IC3DPrinters/filament-extrusion/Open Source Filament/CAD/Breaker Plate/Breaker Plate Outlet.JPG

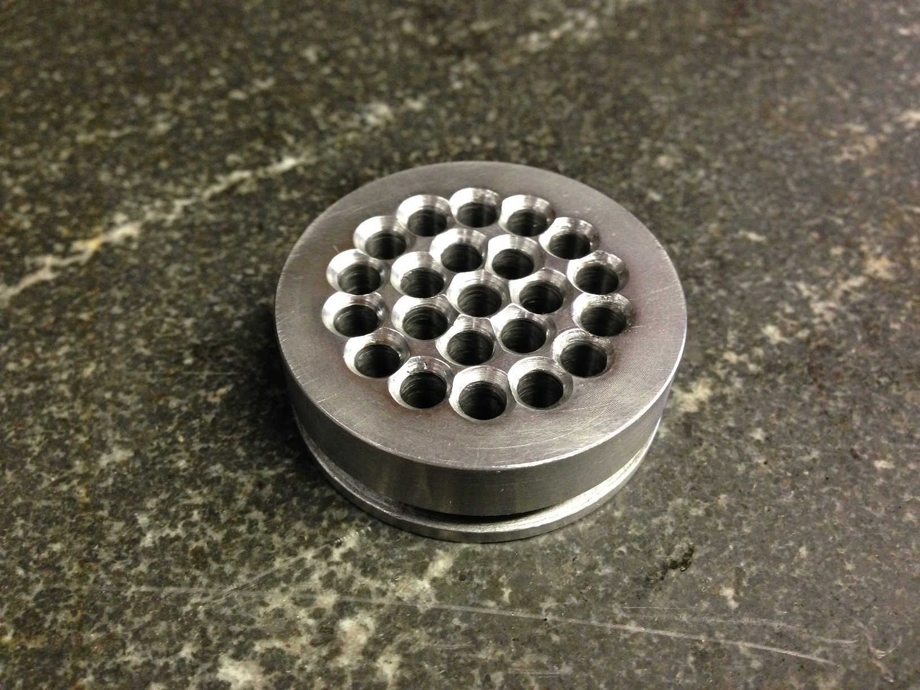
Open Source Filament/CAD/Breaker Plate/Breaker Plate Outlet.JPG
