IC3DPrinters/filament-extrusion/Open Source Filament/Resin Info/ABS Resin/Chimei General PA-747_ISO.pdf

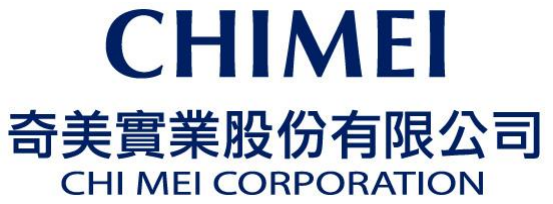
[picture p3: figure]

### No. 59-1, SAN CHIA, JEN TE DISTRICT, TAINAN CITY, TAIWAN TEL: +886-6-266-5000 FAX:+886-6-266-5555~7

The above statement is based on our current level of knowledge and covers the above products directly manufactured and supplied by CHI MEI CORPORATION at the date of issue. CHI MEI CORPORATION makes no warranties, whether express or implied, and assumes no liability in connection with any use of above information. Notwithstanding the foregoing, CHI MEI CORPORATION shall in no event be held obligated or liable for any claims due to or arising from (i) any customer provided, consigned, materials and/or parts, which are incorporated or adopted in the products; (ii) any combination of the products with material not provided or authorized by our company; (iii) any modifications to the products which are made or directed by customer; (iv) our compliance with the specifications, instructions, and/or designs provided by customer; (v) any anti-trust, unfair competition and/or other unlawful actions effected by customer; or (vi) any defects, infringement, breach and/or violation which are arising out of customer’s faults or otherwise not solely and directly attributable to CHI MEI CORPORATION. In no event will CHI MEI CORPORATION be liable for any indirect, special, exemplary, punitive, or consequential damages (including lost profits) of any nature whatsoever whether arising out of the purchase, shipment, unloading, handling, or use of any product or otherwise.

# General ABS POLYLAC® Characteristics PA⁻747

特性

### PROPERTIES

## 測試方法

### ISO TEST METHOD

## 測試條件

### TEST CONDITION

單位

### UNIT

### 通用級 GENERAL

PA-747

熔融指數 Melt Flow Index | 1133 | 220 ℃, 10 Kg | ml/10 min | 13
比重 Mass Density | 1183 | 23 ℃ | g/cm³ | 1.03
硬度 Ball Indentation Hardness | 2039-1 | H358/30 | N/mm² | 88
拉伸強度 Tensile Strength | 527 | 50 mm/min,yield | MPa | 39
| | 50 mm/min,break | MPa | 31
延伸率 Tensile Elongation | 527 | 50 mm/min | % | 45
彎曲強度 Flexural Strength | 178 | 2 mm/min | MPa | 58
彎曲彈性模數 Flexural Modulus | 178 | 2 mm/min | GPa | 1.8
IZOD 衝擊強度 Izod Impact Strength | 180/1A | Notched | Kj/m² | 34
| 180/1C | Unnotched | | -
Charpy 衝擊強度 Charpy Impact Strength | 179 | Notched | Kj/m² | 37
撓衝試驗 Impact Flexural Test | 179/2C | Notched | Kj/m² | 21
| 179/2D | Unnotched | | -
維氏軟化溫度 Vicat Softening Temp. | 306 | 1 Kg,50 ℃/hr | ℃ | 101
| | 5 Kg,50 ℃/hr | | 92
| | 1 Kg,120 ℃/hr | | 103
| | 5 Kg,120 ℃/hr | | 94
熱變形溫度 Heat Distortion Temp. / A | 75 | 1.8 MPa Unannealed | ℃ | 86
| | 1.8 MPa Annealed | ℃ | 96
UL 燃燒等級 UL Flammability | - | UL-94 | - | 1.5 mm HB

April 8, 2013

Notes：These are typical properties only and are not to be construed as specifications. Users should confirm

results by their own tests.
