IC3DPrinters/filament-extrusion/Open Source Filament/CAD/Breaker Plate/Breaker Plate Inlet.JPG

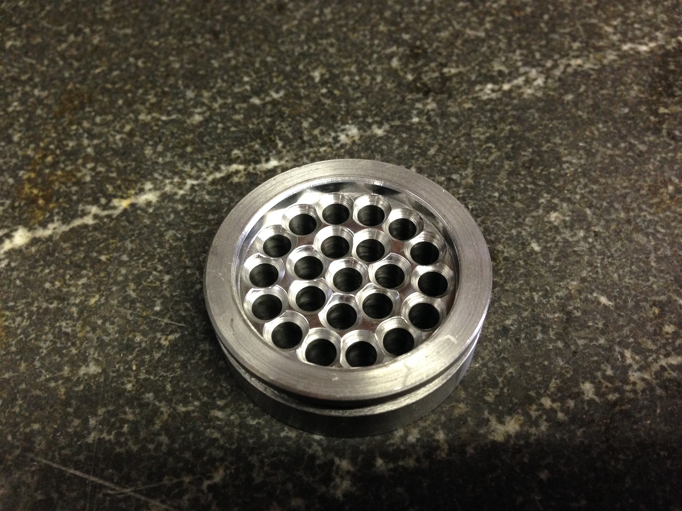
Open Source Filament/CAD/Breaker Plate/Breaker Plate Inlet.JPG
