IC3DPrinters/filament-extrusion/Open Source Filament/CAD/Extrusion Dies/Extrusion Die 3mm b.jpeg

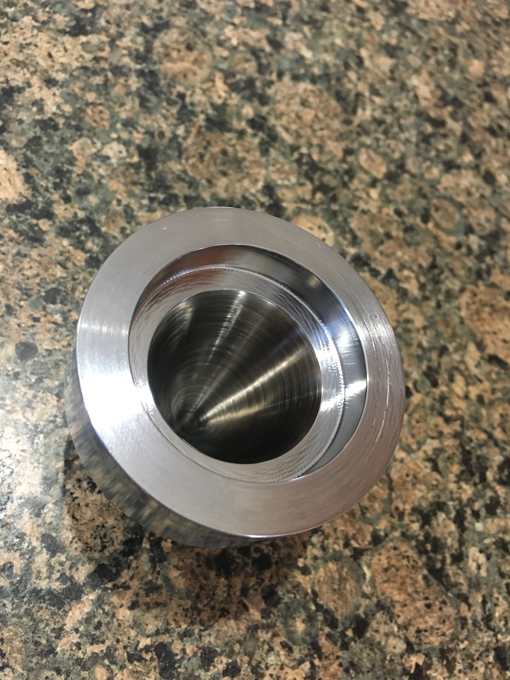
Open Source Filament/CAD/Extrusion Dies/Extrusion Die 3mm b.jpeg
