IC3DPrinters/filament-extrusion/Open Source Filament/CAD/Extrusion Dies/Extrusion Die 3mm c.jpeg

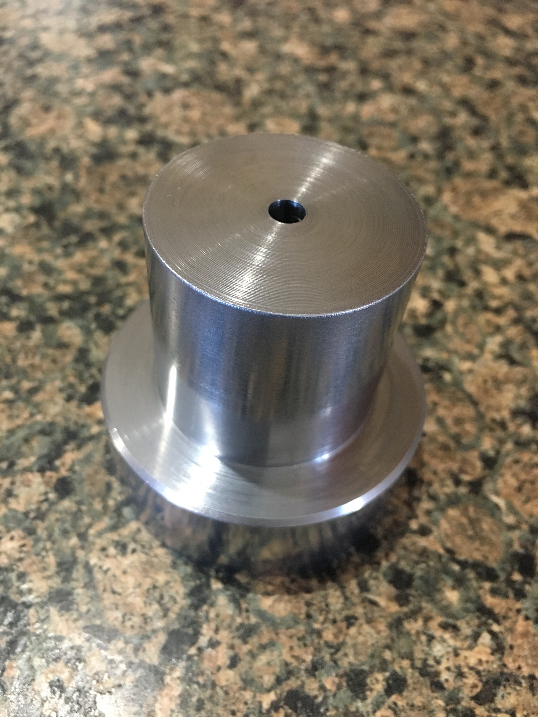
Open Source Filament/CAD/Extrusion Dies/Extrusion Die 3mm c.jpeg
