IC3DPrinters/filament-extrusion/Open Source Filament/CAD/Filament Stabilizers/Filament Vertical CrossSection.jpg

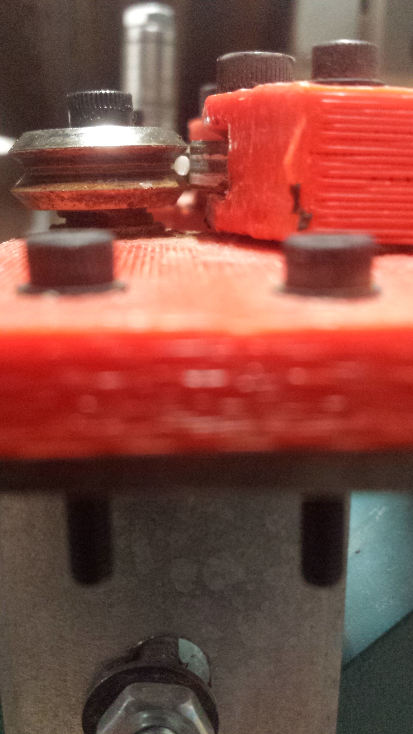
Open Source Filament/CAD/Filament Stabilizers/Filament Vertical CrossSection.jpg
