IC3DPrinters/filament-extrusion/Open Source Filament/Media/ABSNatural.png

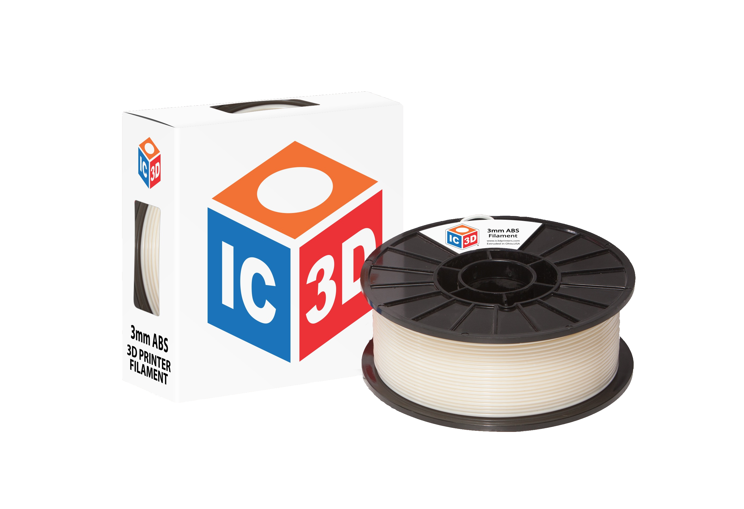
Open Source Filament/Media/ABSNatural.png
