IC3DPrinters/filament-extrusion/Open Source Filament/CAD/Respooler/HBLFSN6.sldasm

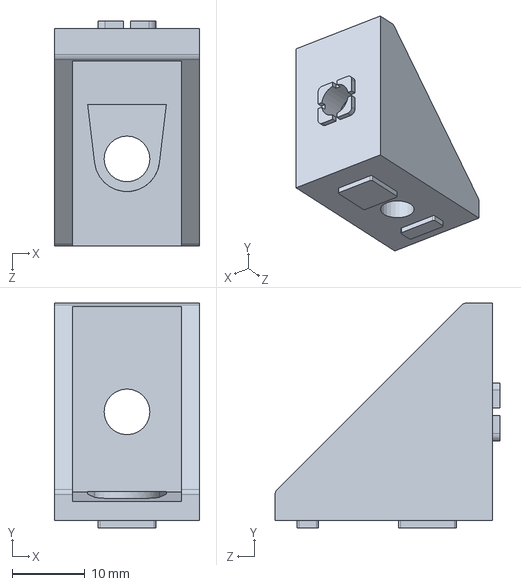
[picture p9: CAD file, 2017-04-15]
Open Source Filament/CAD/Respooler/HBLFSN6.sldasm
20.0 x 31.0 x 31.0 mm
