IC3DPrinters/filament-extrusion/Open Source Filament/CAD/Respooler/Pulley Assy Traverse.SLDASM

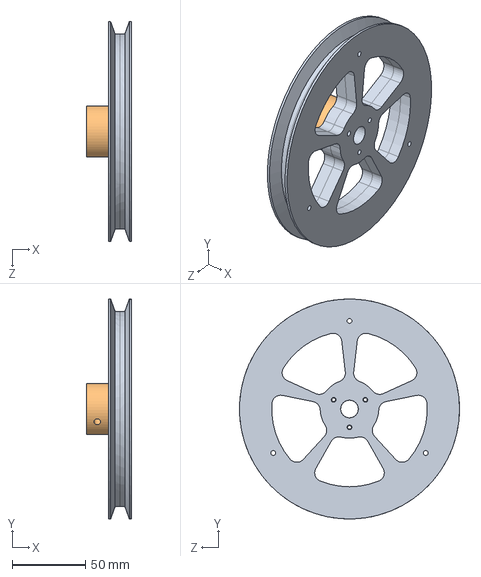
[picture p10: CAD file, 2017-04-15]
Open Source Filament/CAD/Respooler/Pulley Assy Traverse.SLDASM
31.0 x 149.9 x 150.0 mm
Pulley Outer Traverse x 2
Adapter Traverse Pulley
