IC3DPrinters/filament-extrusion/Open Source Filament/CAD/Filament Stabilizers/Filament Holder Subassy.SLDASM

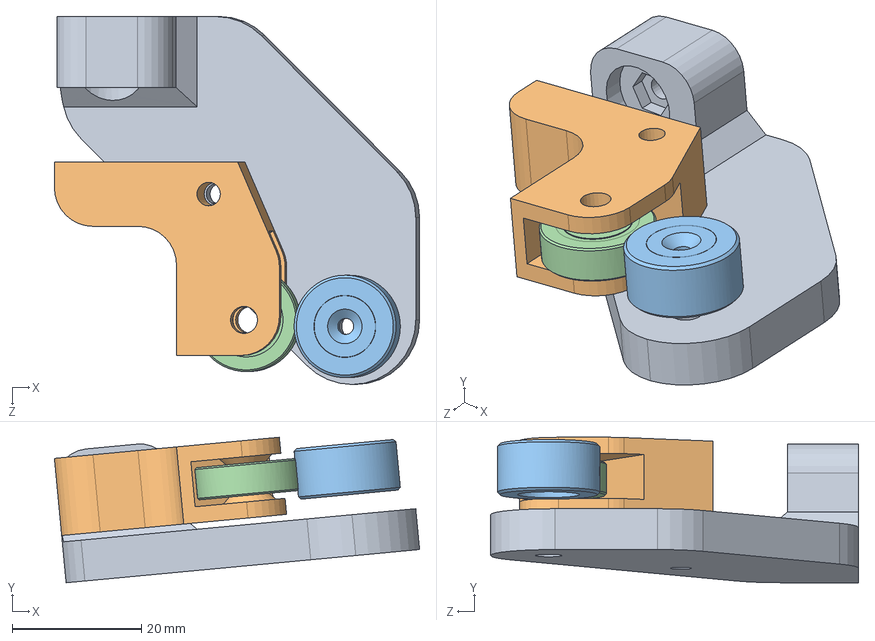
[picture p11: CAD file, 2017-04-15]
Open Source Filament/CAD/Filament Stabilizers/Filament Holder Subassy.SLDASM
56.6 x 22.5 x 57.0 mm
Bearing Plate
Bearing spring loaded holder
3_16 Groove Bearing
6153K150
