IC3DPrinters/filament-extrusion/Open Source Filament/CAD/Filament Stabilizers/Laser Filament Holder.SLDASM

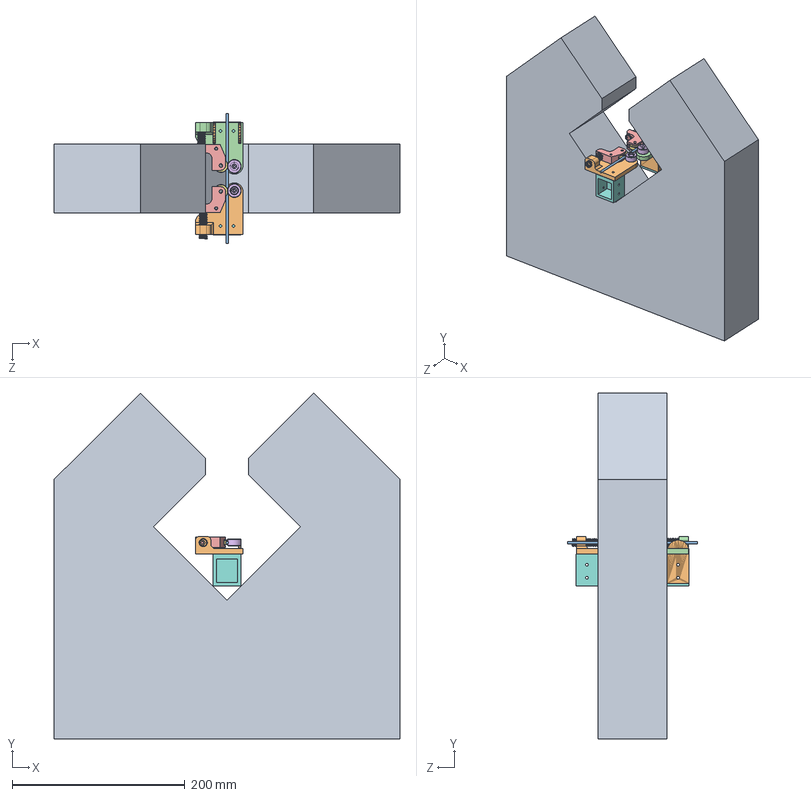
[picture p12: CAD file, 2017-04-15]
Open Source Filament/CAD/Filament Stabilizers/Laser Filament Holder.SLDASM
400.0 x 400.0 x 150.0 mm
Laser Gauge
3mm Filament
Bearing Plate
Bearing spring loaded holder x 2
3_16 Groove Bearing x 2
6153K150 x 2
Mount Block x 2
Spring 0.375 9657K135 x 2
Bearing Plate Sym
