IC3DPrinters/filament-extrusion/Open Source Filament/CAD/Respooler/Large Spool Payoff.sldasm

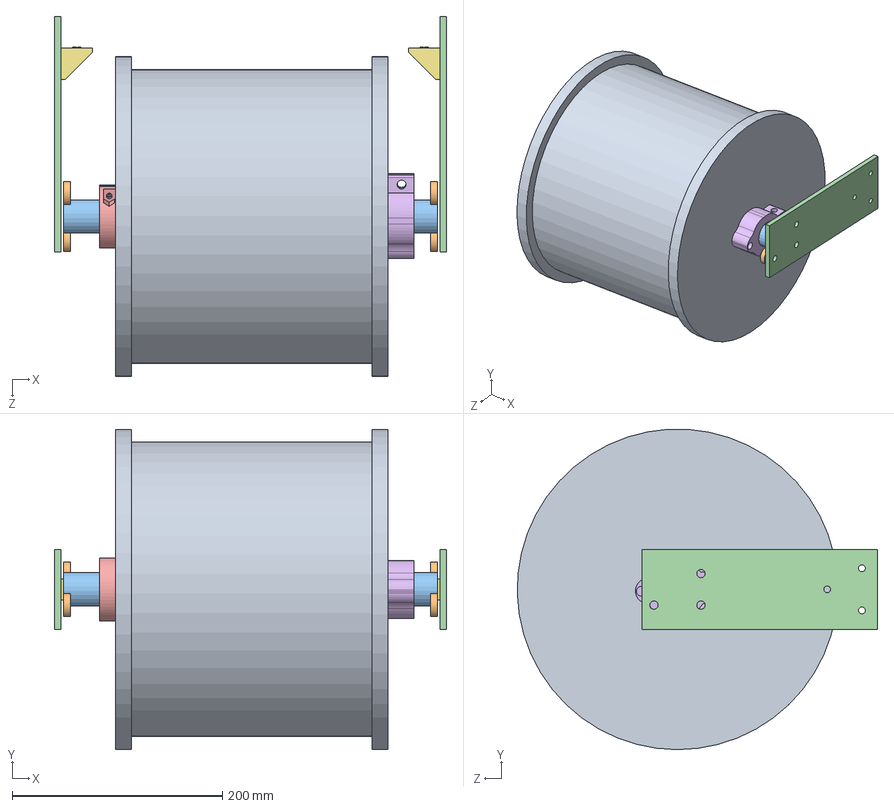
[picture p13: CAD file, 2017-04-15]
Open Source Filament/CAD/Respooler/Large Spool Payoff.sldasm
372.7 x 304.5 x 342.6 mm
Spool 12in
C608ZZ x 6
Rod Spool Big
Side Plate Big Spool x 2
Spooler Stopper Fixed
Spooler Stopper Quick
HBLFSN6_ x 2
