IC3DPrinters/filament-extrusion/Open Source Filament/CAD/Filament Stabilizers/Filament Holder Subassy Sym.SLDASM

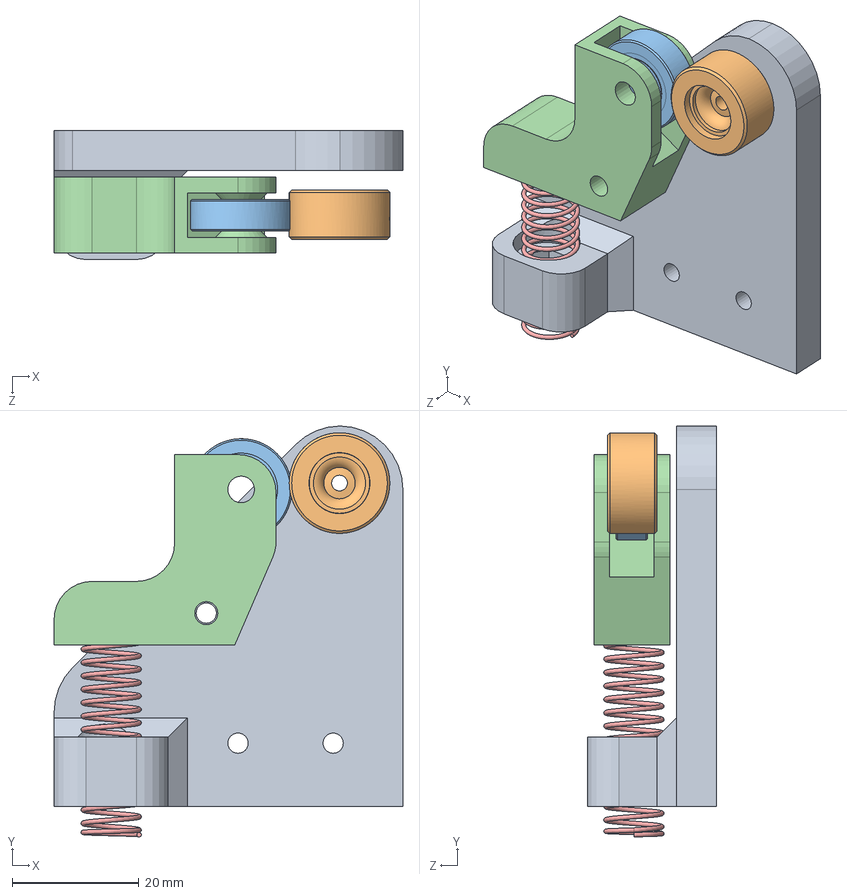
[picture p14: CAD file, 2017-04-15]
Open Source Filament/CAD/Filament Stabilizers/Filament Holder Subassy Sym.SLDASM
55.0 x 64.8 x 20.3 mm
Bearing Plate Sym
3_16 Groove Bearing
6153K150
Bearing spring loaded holder
Spring 0.375 9657K135
