IC3DPrinters/filament-extrusion/Open Source Filament/CAD/Respooler/Pulley Assy Motor.SLDASM

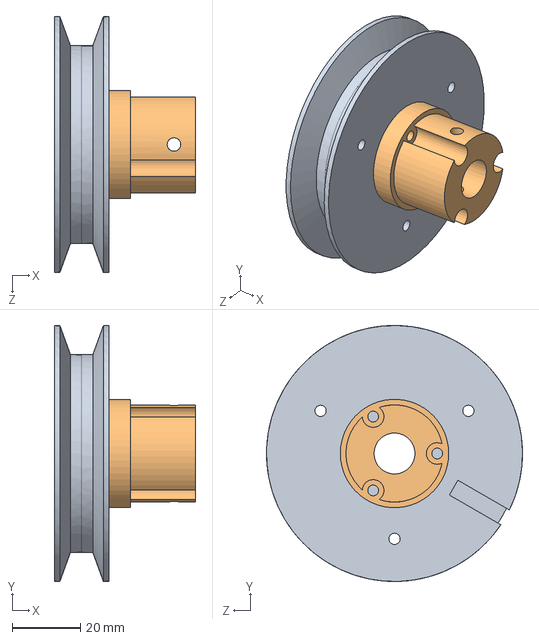
[picture p15: CAD file, 2017-04-15]
Open Source Filament/CAD/Respooler/Pulley Assy Motor.SLDASM
41.4 x 75.0 x 75.0 mm
Pulley Outer Motor x 2
Pulley Shaft Adapter (Motor)
