IC3DPrinters/filament-extrusion/Open Source Filament/CAD/Respooler/Respooler.SLDASM

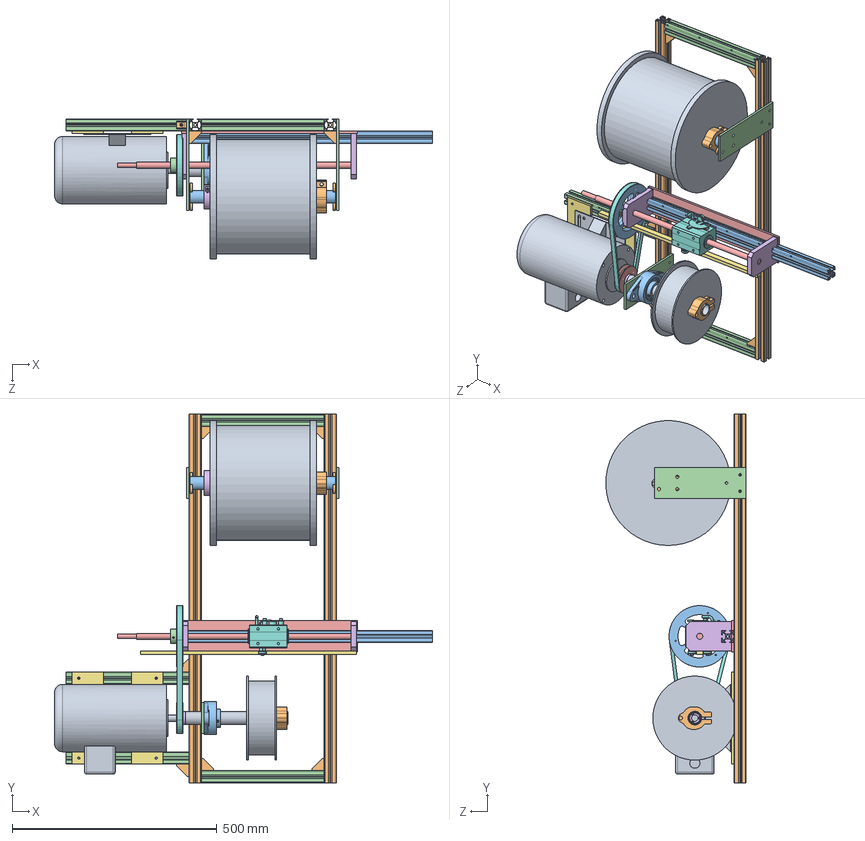
[picture p16: CAD file, 2017-04-15]
Open Source Filament/CAD/Respooler/Respooler.SLDASM
922.7 x 900.0 x 342.6 mm
Spool 8in
HFS6-3030-900 x 2
HFS6-3030-300 x 4
Traverse Spindle
Traverse Endplate x 2
Traverse Stabilizing Beam
Coilaide OKA15_3D
Electric Motor 1HP
HBLFSN6_ x 9
UCFL 206-20_UCFL 2-Bolt Flange Units_IPTCI Bearings__889BF_1CAF338
Mount Pillow Block
Traverse Mount Plate
Spooler Stopper Fixed x 2
M8x12 Flat Screw x 3
Belt
Rod Spool Small
Spooler Stopper Quick x 2
Pulley Outer Traverse x 2
Adapter Traverse Pulley
Pulley Outer Motor x 2
Pulley Shaft Adapter (Motor)
Motor Mount Plate x 2
5_16 Nut
C608ZZ x 6
Rod Spool Big
Side Plate Big Spool x 2
