IC3DPrinters/filament-extrusion/Open Source Filament/CAD/Respooler/Traverse Assy.SLDASM

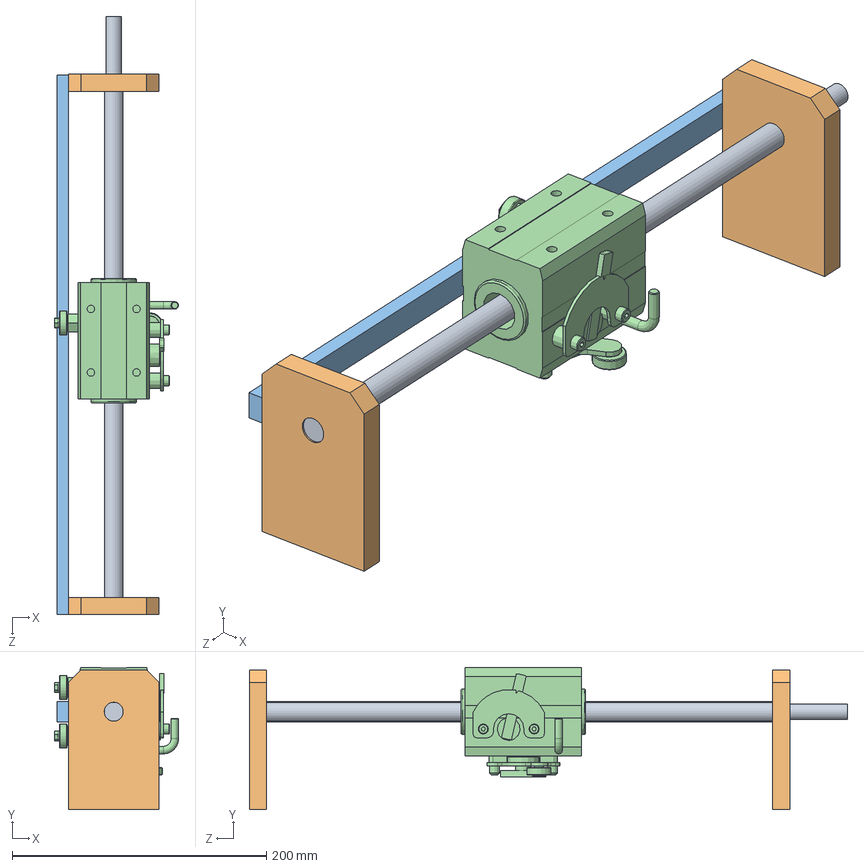
[picture p17: CAD file, 2017-04-15]
Open Source Filament/CAD/Respooler/Traverse Assy.SLDASM
97.8 x 111.8 x 471.0 mm
Traverse Spindle
Traverse Endplate x 2
Traverse Stabilizing Beam
Coilaide OKA15_3D
