IC3DPrinters/filament-extrusion/Open Source Filament/CAD/Breaker Plate/Breaker Plate 2014.01.12.STEP

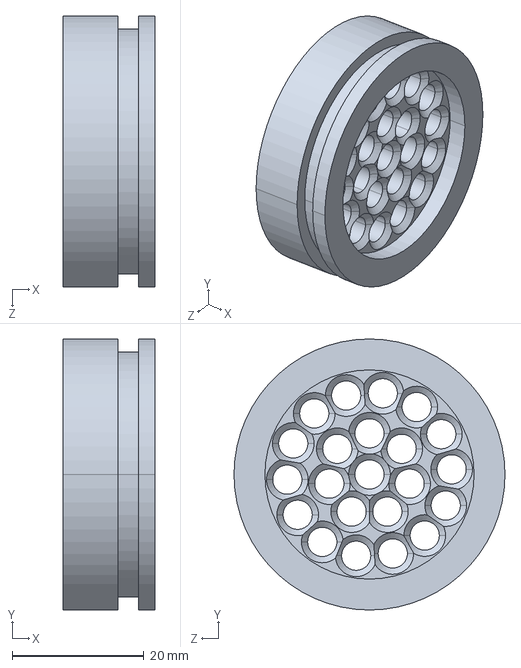
[picture p18: CAD file, 2017-04-15]
Open Source Filament/CAD/Breaker Plate/Breaker Plate 2014.01.12.STEP
14.0 x 41.1 x 41.1 mm
