IC3DPrinters/filament-extrusion/Open Source Filament/CAD/Extrusion Dies/Extrusion Die 1.75mm 2013.12.23.STEP

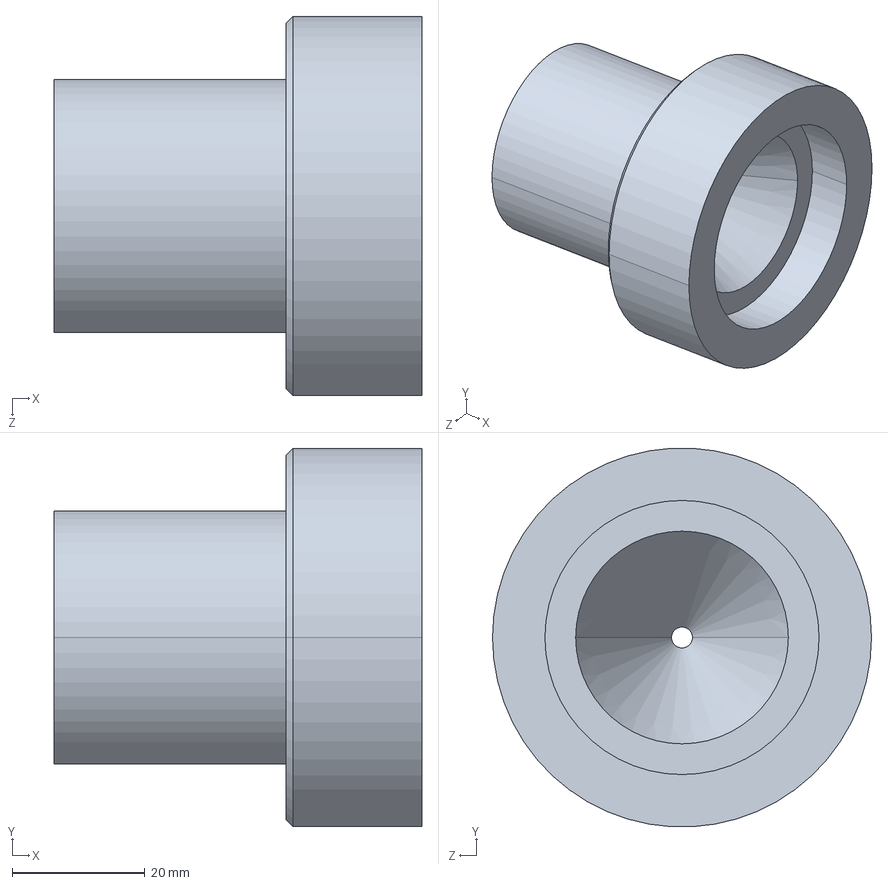
[picture p19: CAD file, 2017-04-15]
Open Source Filament/CAD/Extrusion Dies/Extrusion Die 1.75mm 2013.12.23.STEP
55.3 x 56.9 x 57.0 mm
