IC3DPrinters/filament-extrusion/Open Source Filament/CAD/Respooler/HFS6-3030-300.sldprt

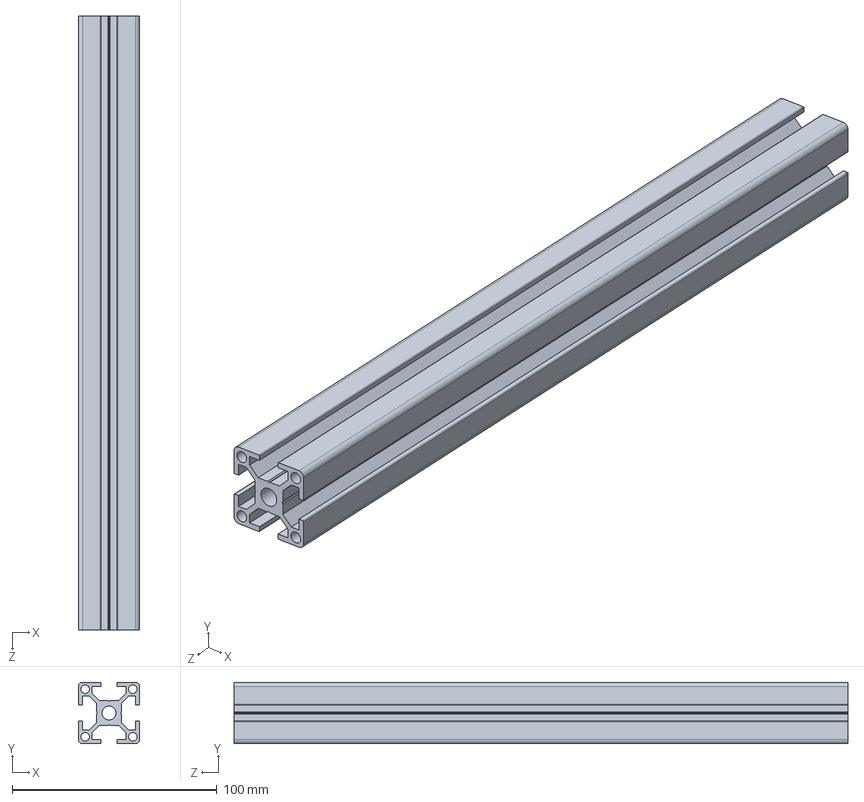
[picture p20: CAD file, 2017-04-15]
Open Source Filament/CAD/Respooler/HFS6-3030-300.sldprt
30.0 x 30.0 x 300.0 mm
