IC3DPrinters/filament-extrusion/Open Source Filament/CAD/Filament Stabilizers/Bearing Plate.sldprt

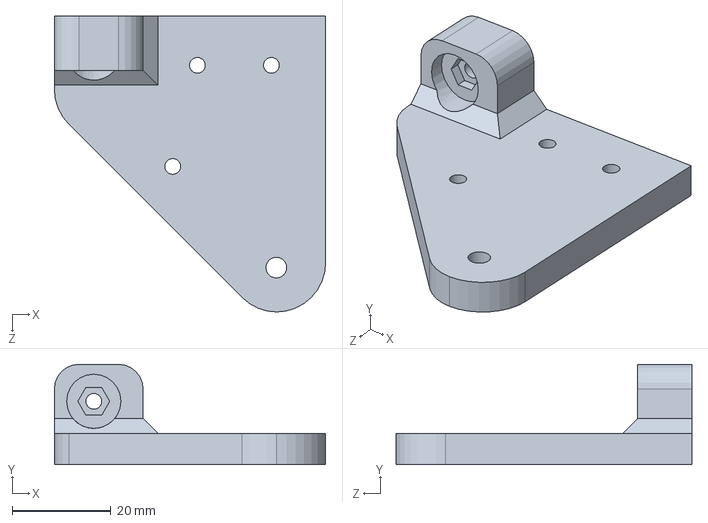
[picture p21: CAD file, 2017-04-15]
Open Source Filament/CAD/Filament Stabilizers/Bearing Plate.sldprt
55.0 x 20.3 x 60.0 mm
