IC3DPrinters/filament-extrusion/Open Source Filament/CAD/Respooler/Traverse Endplate.SLDPRT

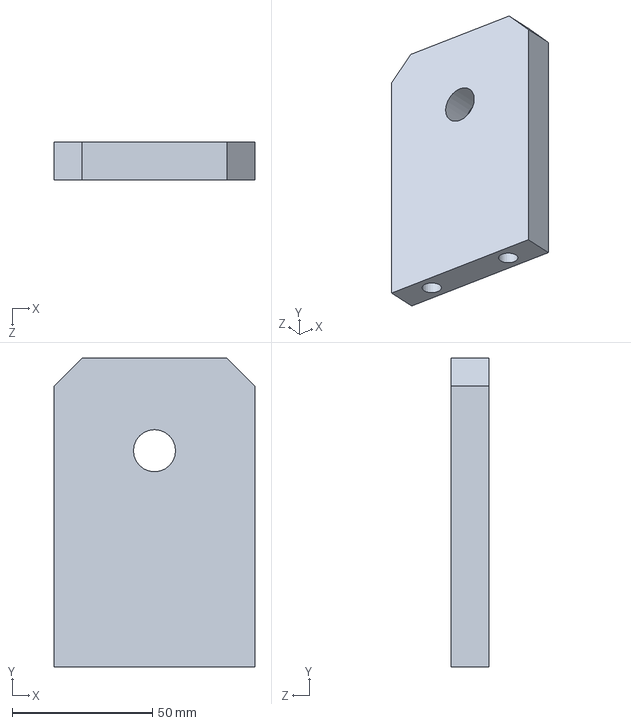
[picture p22: CAD file, 2017-04-15]
Open Source Filament/CAD/Respooler/Traverse Endplate.SLDPRT
71.5 x 110.0 x 13.5 mm
