IC3DPrinters/filament-extrusion/Open Source Filament/CAD/Respooler/Belt.SLDPRT

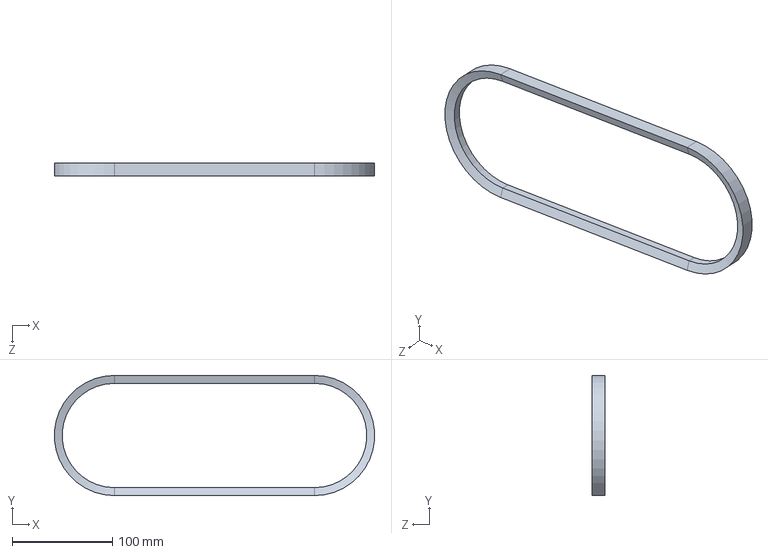
[picture p23: CAD file, 2017-04-15]
Open Source Filament/CAD/Respooler/Belt.SLDPRT
319.6 x 120.0 x 12.7 mm
