IC3DPrinters/filament-extrusion/Open Source Filament/CAD/Filament Stabilizers/Spring Conical 1692K260.SLDPRT

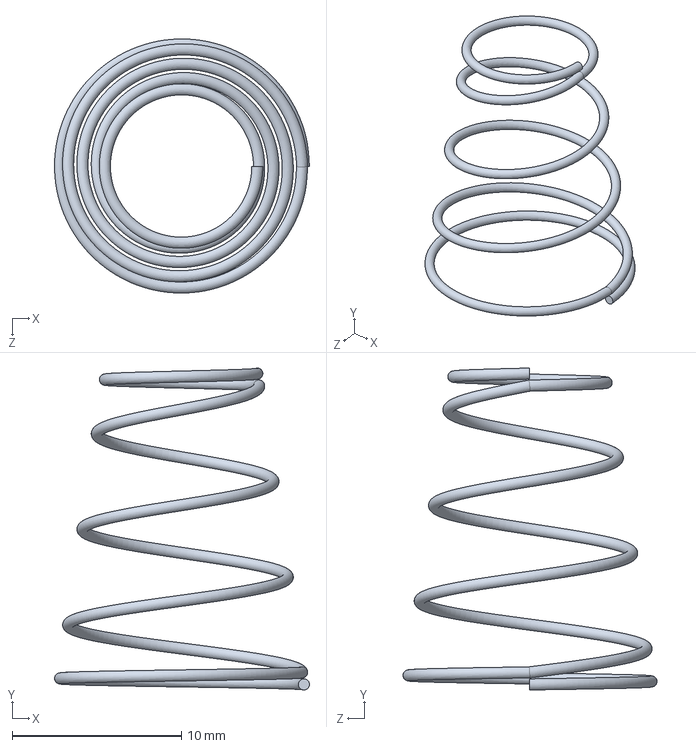
[picture p24: CAD file, 2017-04-15]
Open Source Filament/CAD/Filament Stabilizers/Spring Conical 1692K260.SLDPRT
15.1 x 19.1 x 15.0 mm
