IC3DPrinters/filament-extrusion/Open Source Filament/CAD/Filament Stabilizers/Mount Block.SLDPRT

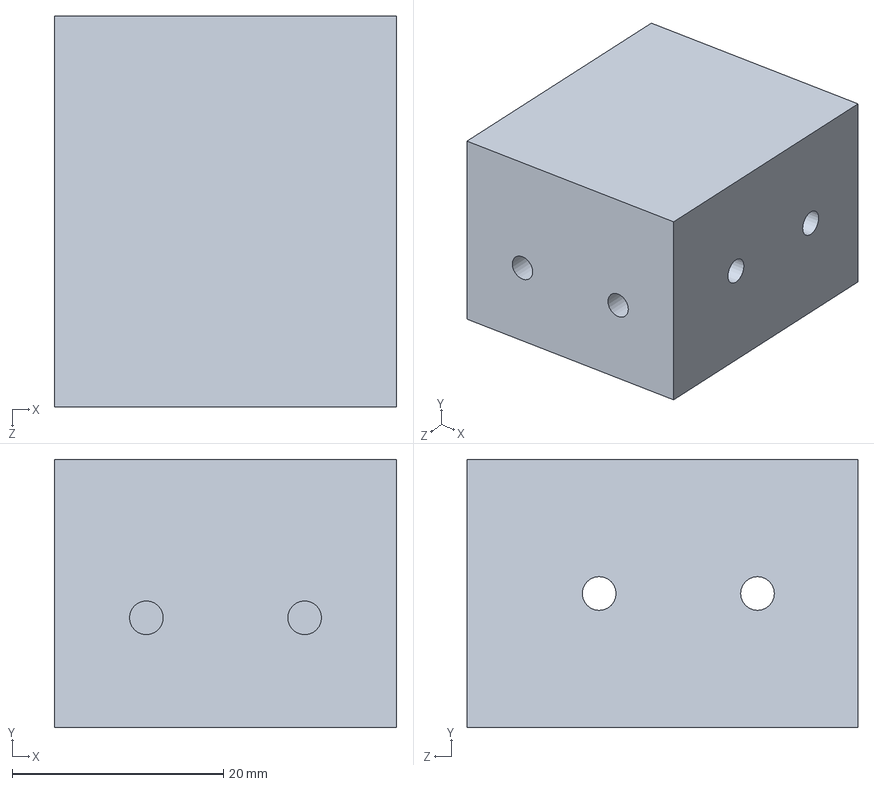
[picture p25: CAD file, 2017-04-15]
Open Source Filament/CAD/Filament Stabilizers/Mount Block.SLDPRT
32.4 x 25.4 x 37.0 mm
