IC3DPrinters/filament-extrusion/Open Source Filament/CAD/Respooler/C608ZZ.sldprt

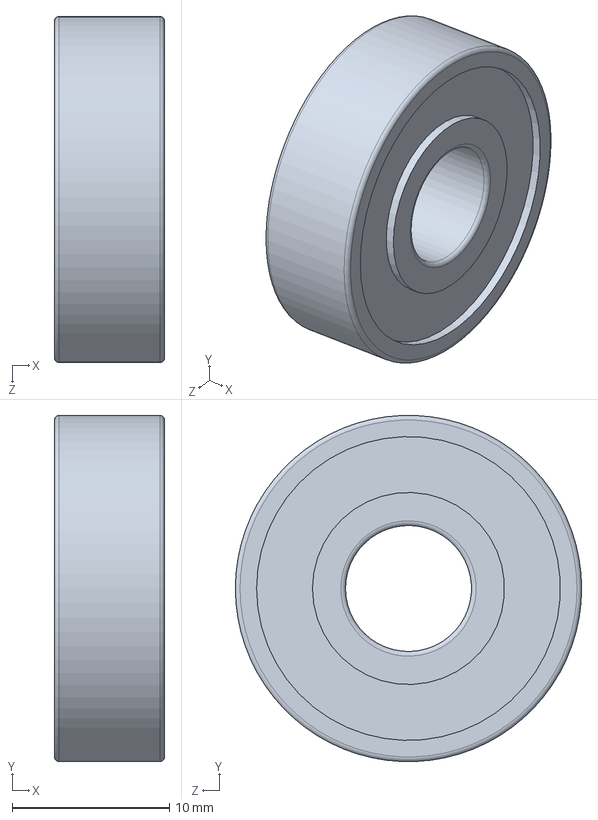
[picture p26: CAD file, 2017-04-15]
Open Source Filament/CAD/Respooler/C608ZZ.sldprt
7.00 x 22.0 x 22.0 mm
