IC3DPrinters/filament-extrusion/Open Source Filament/CAD/Filament Stabilizers/3mm Filament.SLDPRT

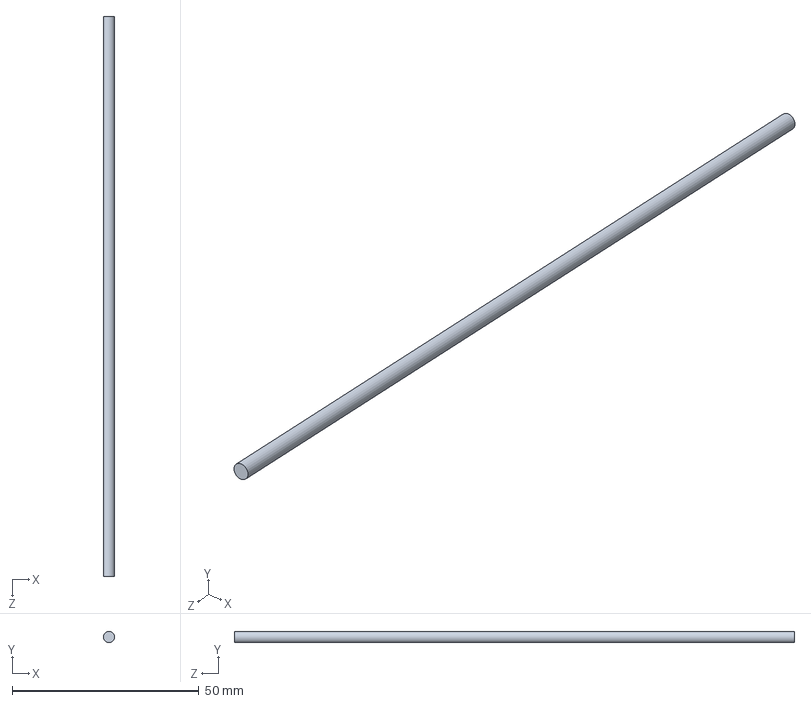
[picture p27: CAD file, 2017-04-15]
Open Source Filament/CAD/Filament Stabilizers/3mm Filament.SLDPRT
3.00 x 3.00 x 150.0 mm
