IC3DPrinters/filament-extrusion/Open Source Filament/CAD/Respooler/Pulley Outer Traverse.SLDPRT

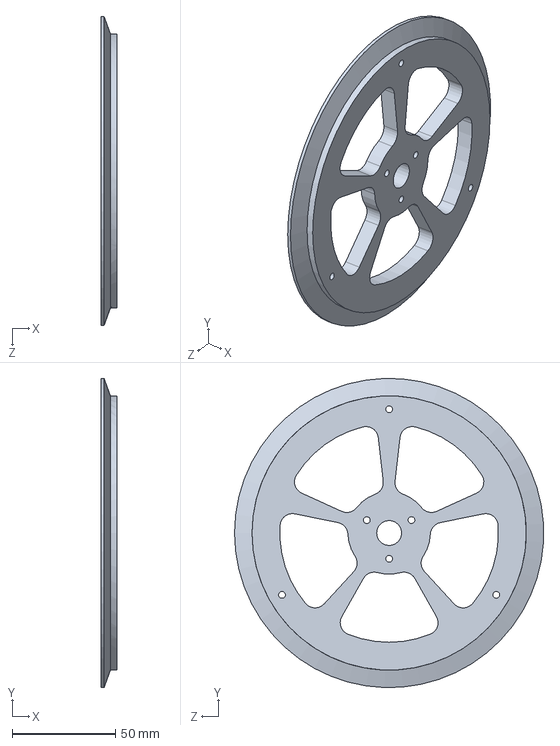
[picture p28: CAD file, 2017-04-15]
Open Source Filament/CAD/Respooler/Pulley Outer Traverse.SLDPRT
8.00 x 149.9 x 149.9 mm
