IC3DPrinters/filament-extrusion/Open Source Filament/CAD/Respooler/Coilaide OKA15_3D.SLDPRT

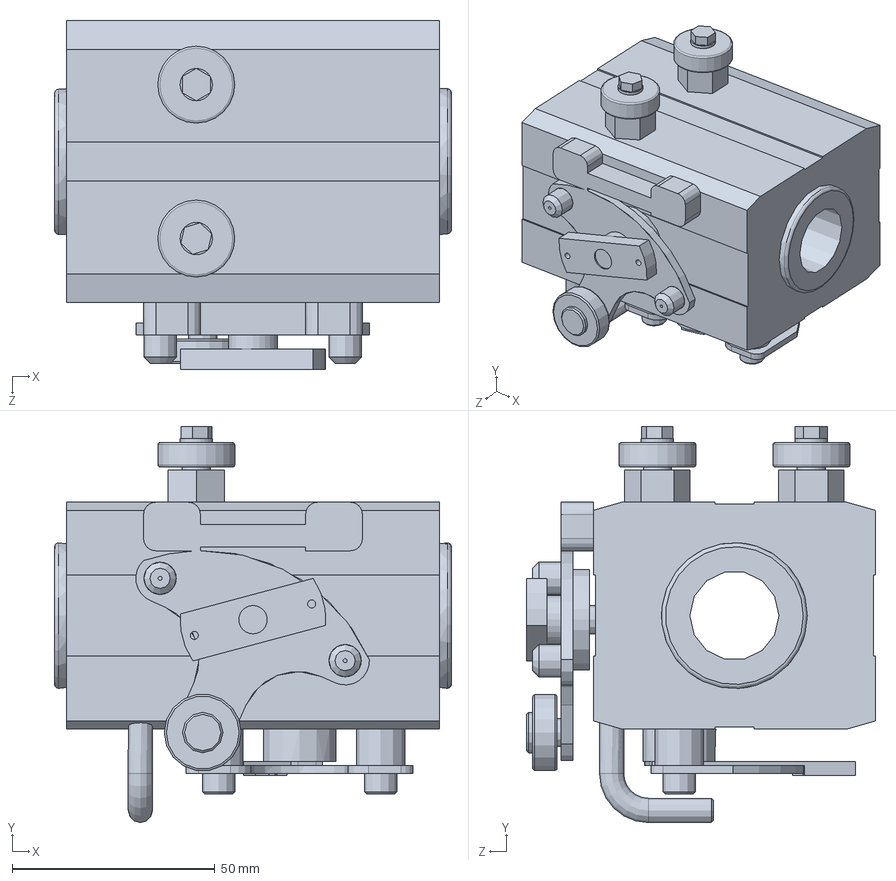
[picture p29: CAD file, 2017-04-15]
Open Source Filament/CAD/Respooler/Coilaide OKA15_3D.SLDPRT
98.0 x 97.8 x 86.1 mm
