IC3DPrinters/filament-extrusion/Open Source Filament/CAD/Filament Stabilizers/Bearing spring loaded holder.SLDPRT

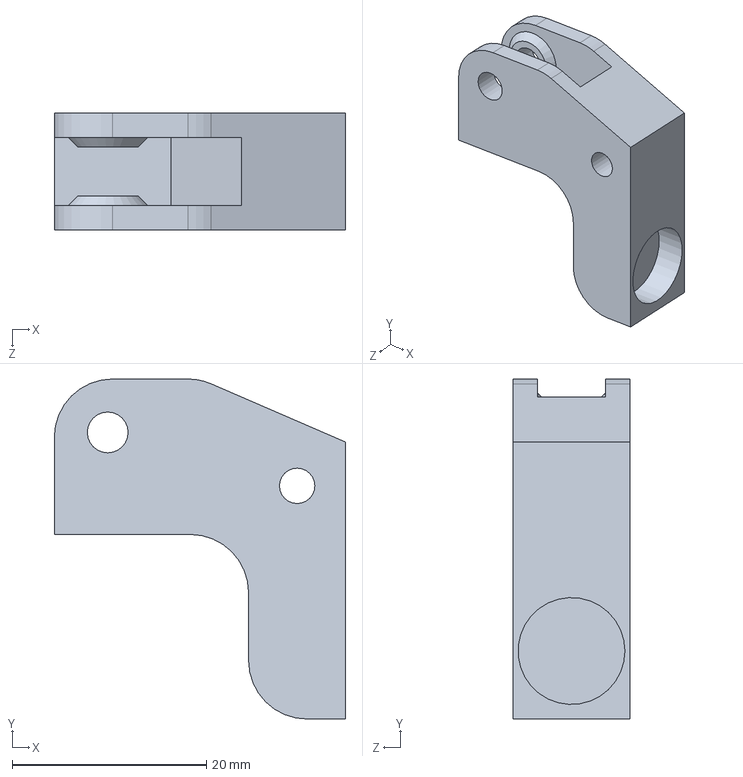
[picture p30: CAD file, 2017-04-15]
Open Source Filament/CAD/Filament Stabilizers/Bearing spring loaded holder.SLDPRT
30.0 x 35.0 x 12.0 mm
