IC3DPrinters/filament-extrusion/Open Source Filament/CAD/Filament Stabilizers/Laser Gauge.SLDPRT

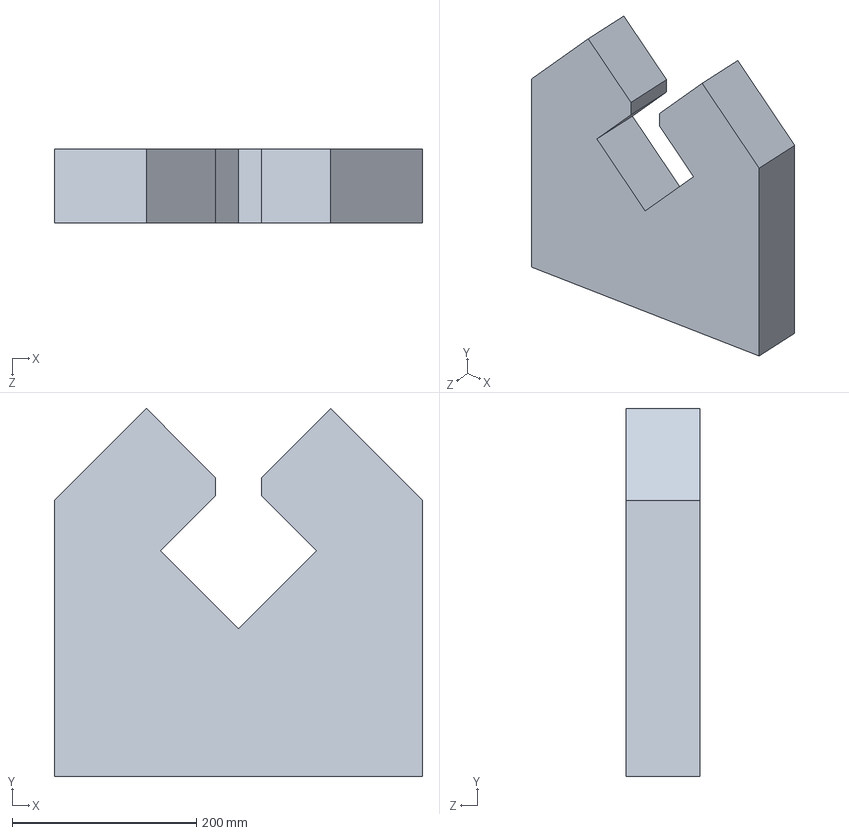
[picture p31: CAD file, 2017-04-15]
Open Source Filament/CAD/Filament Stabilizers/Laser Gauge.SLDPRT
400.0 x 400.0 x 80.0 mm
