IC3DPrinters/filament-extrusion/Open Source Filament/CAD/Respooler/HFS6-3030-600.sldprt

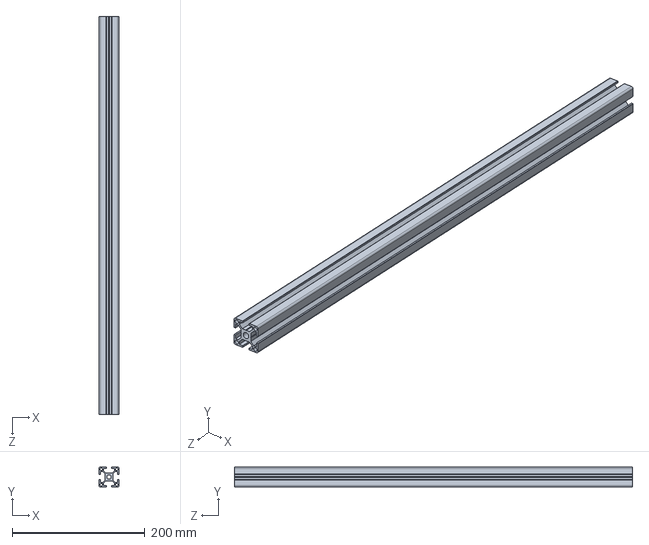
[picture p32: CAD file, 2017-04-15]
Open Source Filament/CAD/Respooler/HFS6-3030-600.sldprt
30.0 x 30.0 x 600.0 mm
