IC3DPrinters/filament-extrusion/Open Source Filament/CAD/Filament Stabilizers/3_16 Groove Bearing.SLDPRT

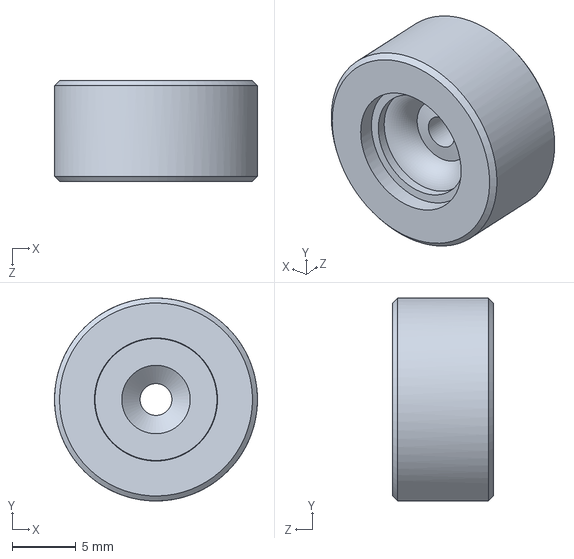
[picture p33: CAD file, 2017-04-15]
Open Source Filament/CAD/Filament Stabilizers/3_16 Groove Bearing.SLDPRT
15.9 x 15.9 x 7.87 mm
