IC3DPrinters/filament-extrusion/Open Source Filament/CAD/Filament Stabilizers/Spring 0.375 9657K135.SLDPRT

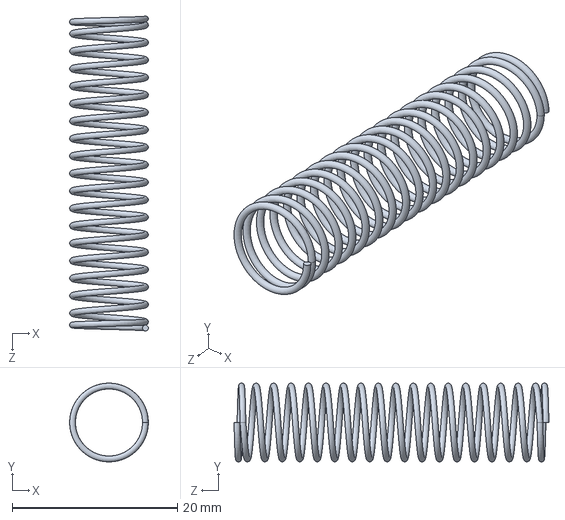
[picture p34: CAD file, 2017-04-15]
Open Source Filament/CAD/Filament Stabilizers/Spring 0.375 9657K135.SLDPRT
9.53 x 9.52 x 38.1 mm
