IC3DPrinters/filament-extrusion/Open Source Filament/CAD/Respooler/Traverse Spindle.SLDPRT

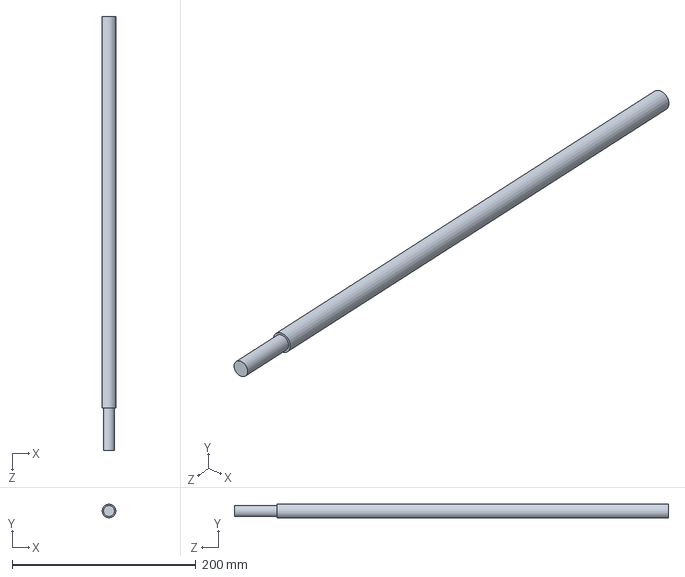
[picture p35: CAD file, 2017-04-15]
Open Source Filament/CAD/Respooler/Traverse Spindle.SLDPRT
15.0 x 15.0 x 472.0 mm
