IC3DPrinters/filament-extrusion/Open Source Filament/CAD/Filament Stabilizers/laser_roller_bracket-A2.SLDPRT

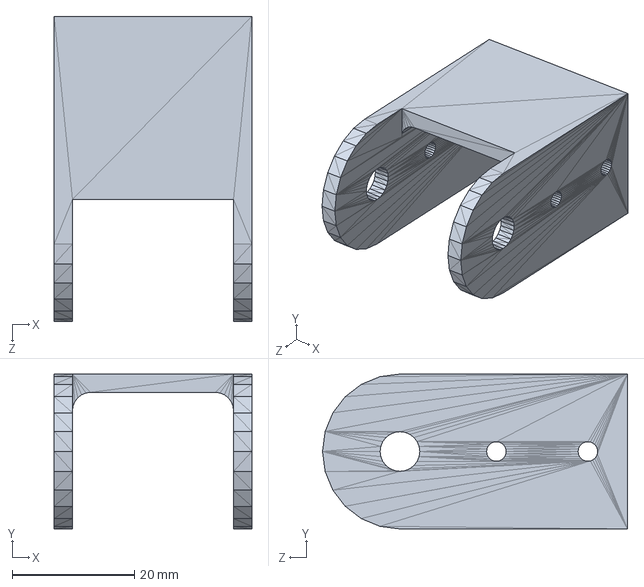
[picture p36: CAD file, 2017-04-15]
Open Source Filament/CAD/Filament Stabilizers/laser_roller_bracket-A2.SLDPRT
32.4 x 25.4 x 50.0 mm
