IC3DPrinters/filament-extrusion/Open Source Filament/CAD/Respooler/Spooler Stopper Fixed.SLDPRT

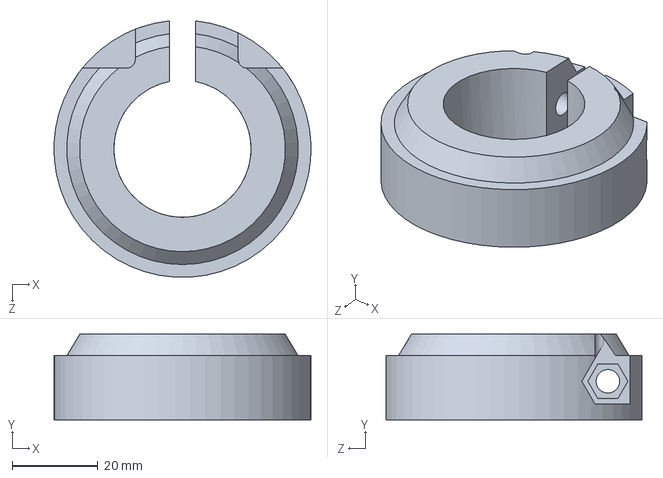
[picture p37: CAD file, 2017-04-15]
Open Source Filament/CAD/Respooler/Spooler Stopper Fixed.SLDPRT
60.0 x 20.0 x 59.8 mm
