IC3DPrinters/filament-extrusion/Open Source Filament/CAD/Respooler/Spool 8in.SLDPRT

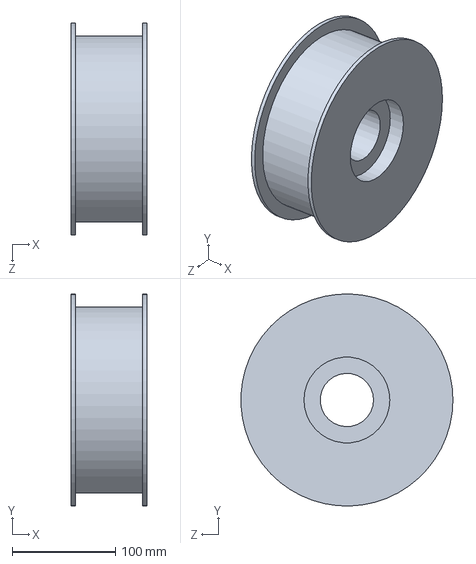
[picture p38: CAD file, 2017-04-15]
Open Source Filament/CAD/Respooler/Spool 8in.SLDPRT
73.0 x 204.9 x 204.8 mm
