IC3DPrinters/filament-extrusion/Open Source Filament/CAD/Respooler/Spooler Stopper Quick.SLDPRT

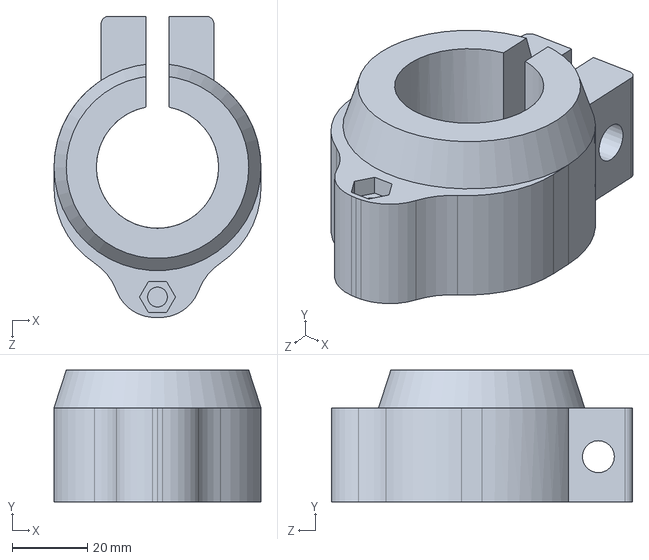
[picture p39: CAD file, 2017-04-15]
Open Source Filament/CAD/Respooler/Spooler Stopper Quick.SLDPRT
55.0 x 35.0 x 80.1 mm
