IC3DPrinters/filament-extrusion/Open Source Filament/CAD/Respooler/Pulley Shaft Adapter (Motor).SLDPRT

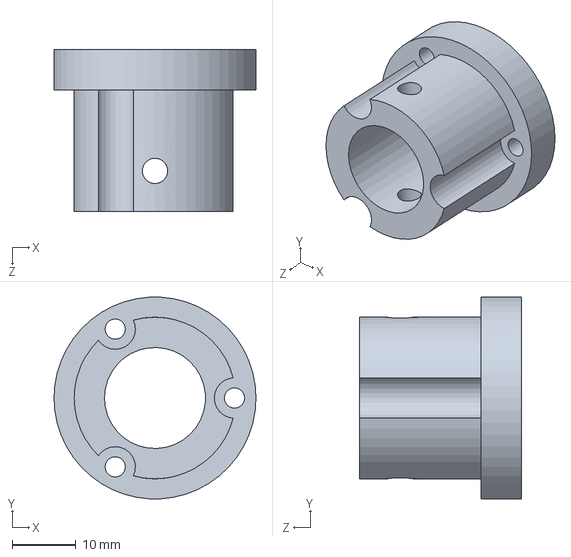
[picture p40: CAD file, 2017-04-15]
Open Source Filament/CAD/Respooler/Pulley Shaft Adapter (Motor).SLDPRT
31.8 x 31.7 x 25.4 mm
