IC3DPrinters/filament-extrusion/Open Source Filament/CAD/Respooler/Pulley Outer Motor.SLDPRT

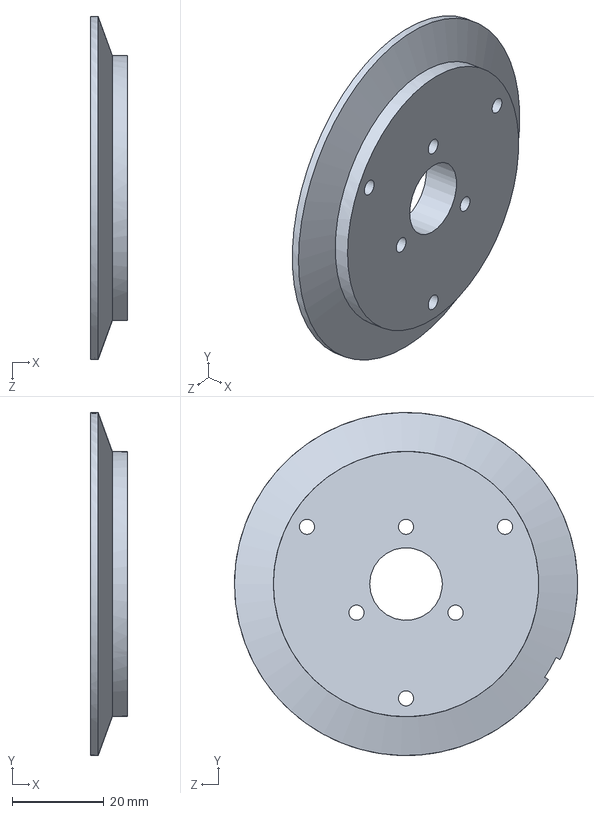
[picture p41: CAD file, 2017-04-15]
Open Source Filament/CAD/Respooler/Pulley Outer Motor.SLDPRT
8.00 x 75.0 x 75.0 mm
