IC3DPrinters/filament-extrusion/Open Source Filament/CAD/Respooler/Motor Mount Plate.SLDPRT

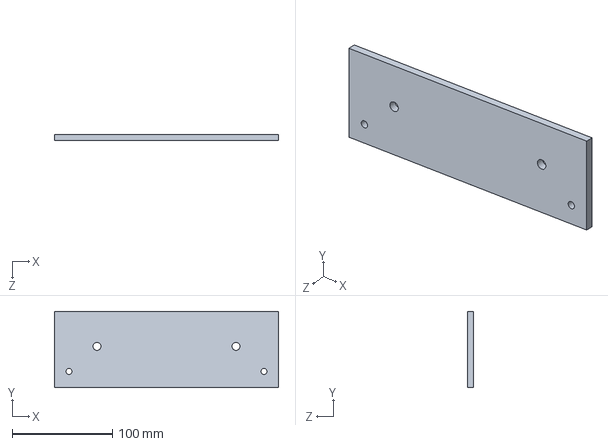
[picture p42: CAD file, 2017-04-15]
Open Source Filament/CAD/Respooler/Motor Mount Plate.SLDPRT
224.0 x 76.2 x 6.35 mm
