IC3DPrinters/filament-extrusion/Open Source Filament/CAD/Respooler/Adapter Traverse Pulley.SLDPRT

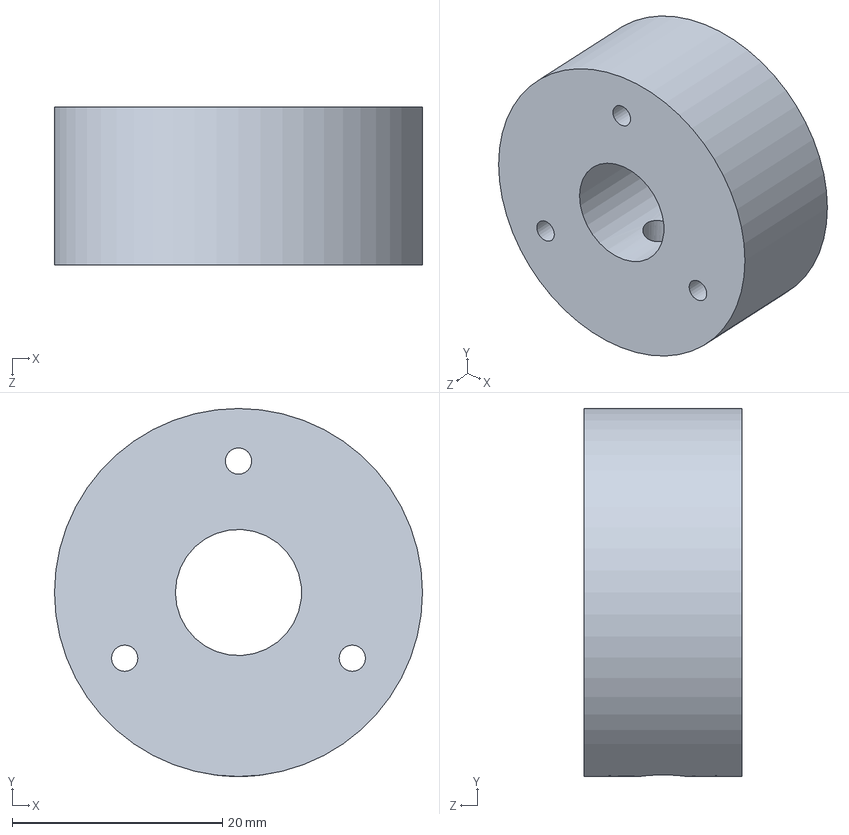
[picture p43: CAD file, 2017-04-15]
Open Source Filament/CAD/Respooler/Adapter Traverse Pulley.SLDPRT
35.0 x 35.0 x 15.0 mm
