IC3DPrinters/filament-extrusion/Open Source Filament/CAD/Respooler/Side Plate Big Spool.SLDPRT

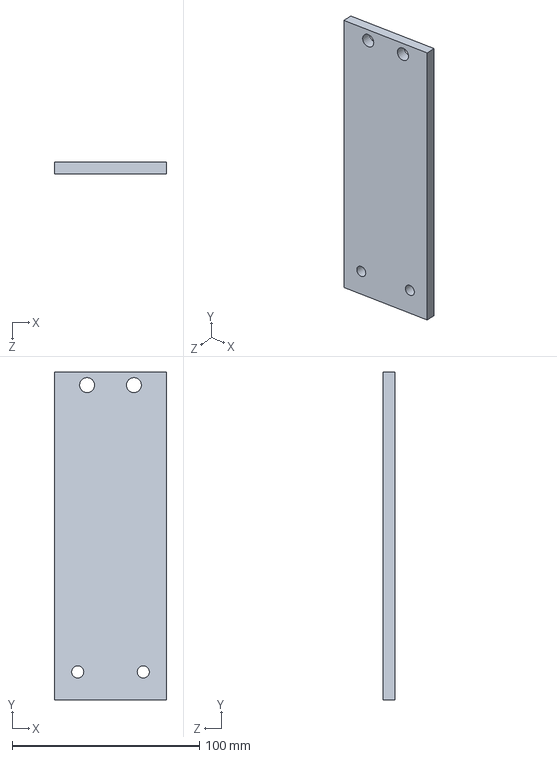
[picture p44: CAD file, 2017-04-15]
Open Source Filament/CAD/Respooler/Side Plate Big Spool.SLDPRT
60.0 x 175.0 x 6.35 mm
