IC3DPrinters/filament-extrusion/Open Source Filament/CAD/Respooler/Spool 12in.SLDPRT

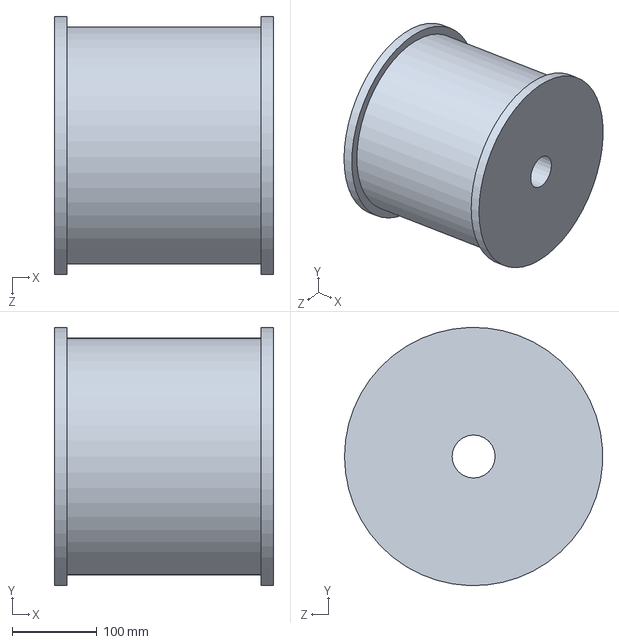
[picture p45: CAD file, 2017-04-15]
Open Source Filament/CAD/Respooler/Spool 12in.SLDPRT
259.0 x 304.6 x 304.5 mm
