IC3DPrinters/filament-extrusion/Open Source Filament/CAD/Respooler/HFS6-3030-900.sldprt

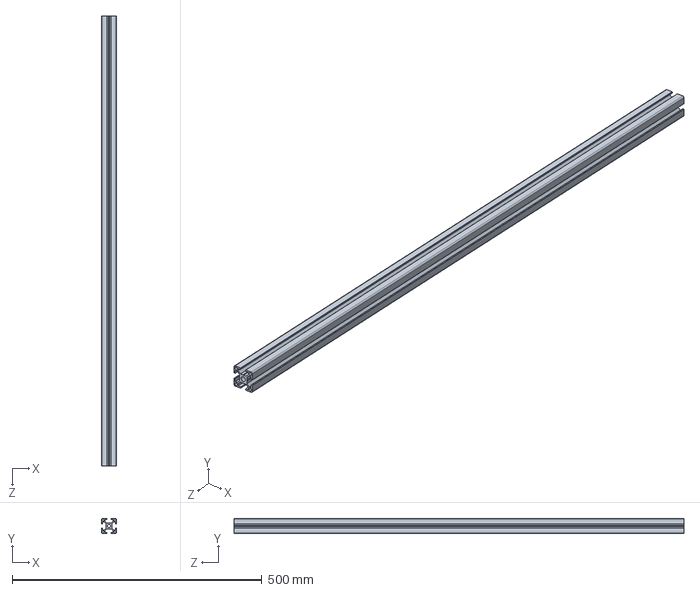
[picture p46: CAD file, 2017-04-15]
Open Source Filament/CAD/Respooler/HFS6-3030-900.sldprt
30.0 x 30.0 x 900.0 mm
