IC3DPrinters/filament-extrusion/Open Source Filament/CAD/Respooler/Rod Spool Big.SLDPRT

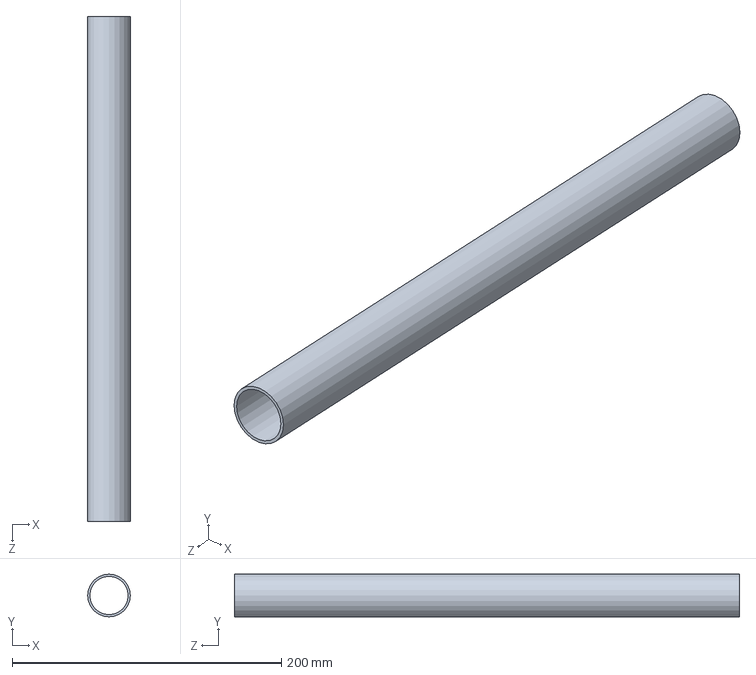
[picture p47: CAD file, 2017-04-15]
Open Source Filament/CAD/Respooler/Rod Spool Big.SLDPRT
31.8 x 31.8 x 375.0 mm
