IC3DPrinters/filament-extrusion/Open Source Filament/CAD/Respooler/Mount Pillow Block.SLDPRT

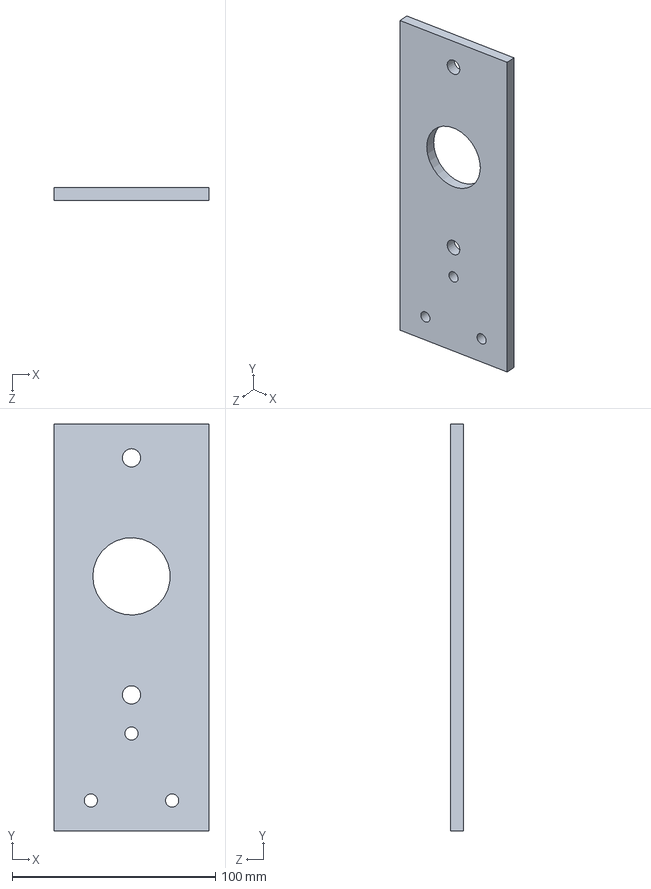
[picture p48: CAD file, 2017-04-15]
Open Source Filament/CAD/Respooler/Mount Pillow Block.SLDPRT
76.2 x 200.4 x 6.35 mm
