IC3DPrinters/filament-extrusion/Open Source Filament/CAD/Respooler/Electric Motor 1HP.SLDPRT

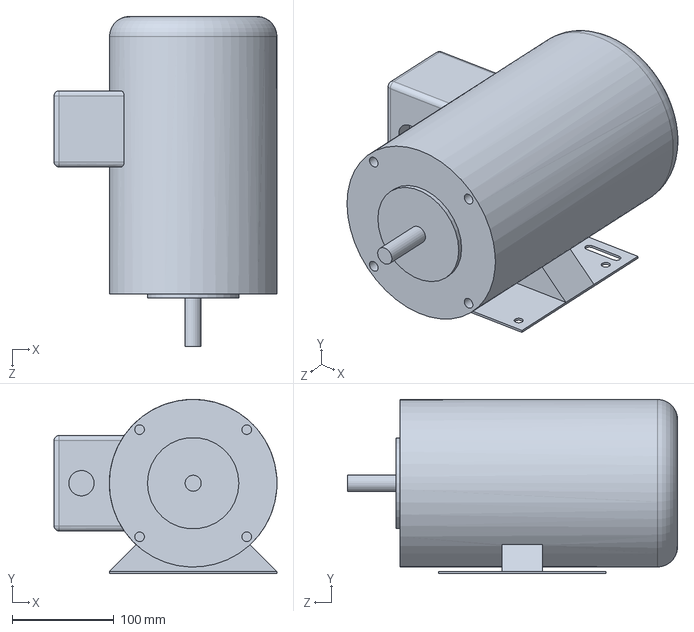
[picture p49: CAD file, 2017-04-15]
Open Source Filament/CAD/Respooler/Electric Motor 1HP.SLDPRT
219.5 x 171.5 x 325.2 mm
