IC3DPrinters/filament-extrusion/Open Source Filament/CAD/Respooler/Traverse Stabilizing Beam.SLDPRT

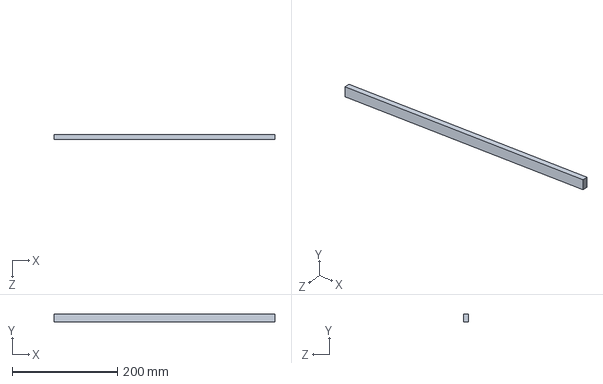
[picture p50: CAD file, 2017-04-15]
Open Source Filament/CAD/Respooler/Traverse Stabilizing Beam.SLDPRT
420.0 x 16.0 x 9.00 mm
