IC3DPrinters/filament-extrusion/Open Source Filament/CAD/Respooler/Traverse Mount Plate.SLDPRT

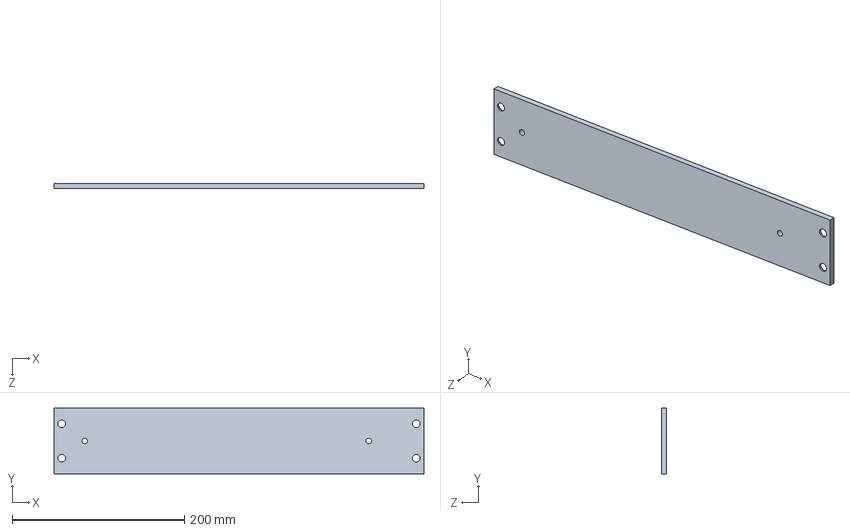
[picture p51: CAD file, 2017-04-15]
Open Source Filament/CAD/Respooler/Traverse Mount Plate.SLDPRT
430.0 x 76.2 x 6.35 mm
