IC3DPrinters/filament-extrusion/Open Source Filament/CAD/Respooler/Rod Spool Small.SLDPRT

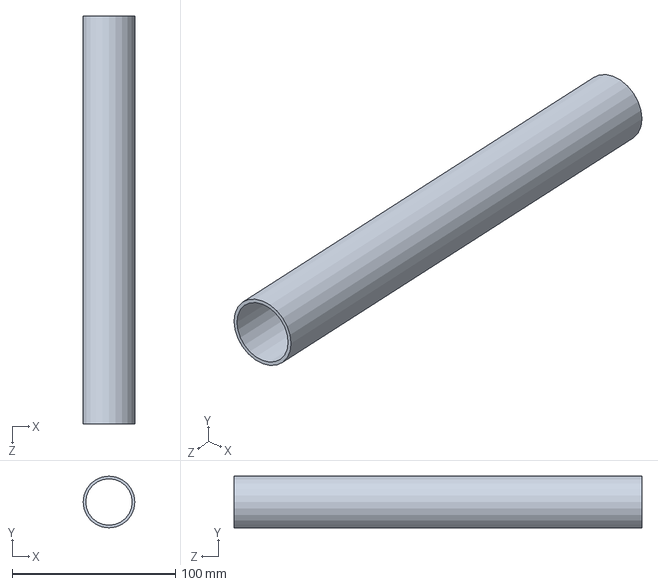
[picture p52: CAD file, 2017-04-15]
Open Source Filament/CAD/Respooler/Rod Spool Small.SLDPRT
31.8 x 31.8 x 250.0 mm
