IC3DPrinters/filament-extrusion/(list of files, cad)

Other CAD files:
Open Source Filament/CAD/Extrusion Dies/Extrusion Die 3mm 2013.12.23.STEP
Open Source Filament/CAD/Filament Stabilizers/Bearing Plate Sym.sldprt
Open Source Filament/CAD/Filament Stabilizers/6153K150.SLDPRT
Open Source Filament/CAD/Filament Stabilizers/Bearing Plate Sym.STL
Open Source Filament/CAD/Filament Stabilizers/Bearing Plate.STL
Open Source Filament/CAD/Filament Stabilizers/Bearing spring loaded holder.STL
Open Source Filament/CAD/Filament Stabilizers/M3 Washer.SLDPRT
Open Source Filament/CAD/Filament Stabilizers/Mount Block.STL
Open Source Filament/CAD/Respooler/5_16 Nut.SLDPRT
Open Source Filament/CAD/Respooler/HBLFSN6_.sldprt
Open Source Filament/CAD/Respooler/M8x12 Flat Screw.SLDPRT
Open Source Filament/CAD/Respooler/UCFL 206-20_UCFL 2-Bolt Flange Units_IPTCI Bearings__889BF_1CAF338.SLDPRT
