IC3DPrinters/filament-extrusion/Open Source Filament/Resin Info/ABS Resin/Chimei General PA-747_Process Guide.pdf

59-1 SAN CHIA, JEN TE, TAINAN COUNTY, TAIWAN. TEL: 886-6-266-5000 FAX: 886-6-266-5555~7

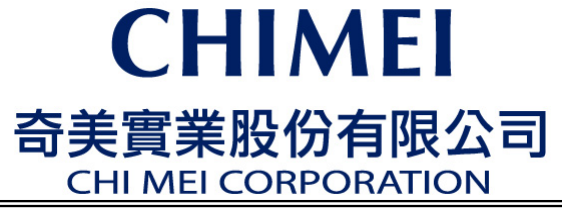
[picture p81: figure]

## General Purpose ABS, POLYLAC®

PA-747

## Processing Conditions

A Pre-drying 80 ~ 85 °C x 2 ~ 4 hrs

depending on a) Humidity
b) Ratio of reground resin
c) Storage conditions

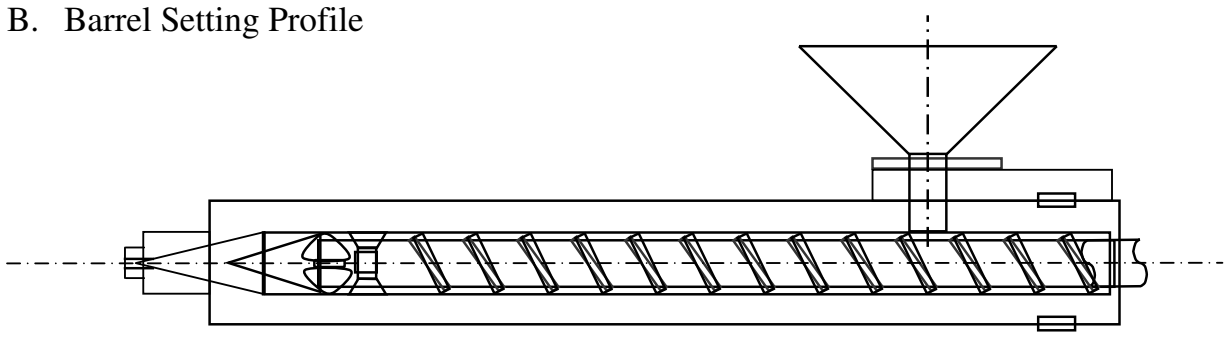
[picture p82: figure]
B. Barrel Setting Profile

MAX(°C) 230 | 230 | 220
MIN(°C) 190 | 190 | 180
C. Mold Temperature | 30~70 °C
depending on | a) Thickness
b) Dimension
c) Gate and runner system
NOTE :
1. Keep the resin from dust and contamination during handling and production.
2. Do not retain the hot melt at the barrel for a long time between injection cycles.

### 3. Temperature setting of manifold system should not exceed 240°C to avoid melt from

degraded.

4. For further information, please contact your local agent or call via +886-6-2665555.
