IC3DPrinters/filament-extrusion/Open Source Filament/CAD/Breaker Plate/Breaker Plate 2014.01.12.PDF

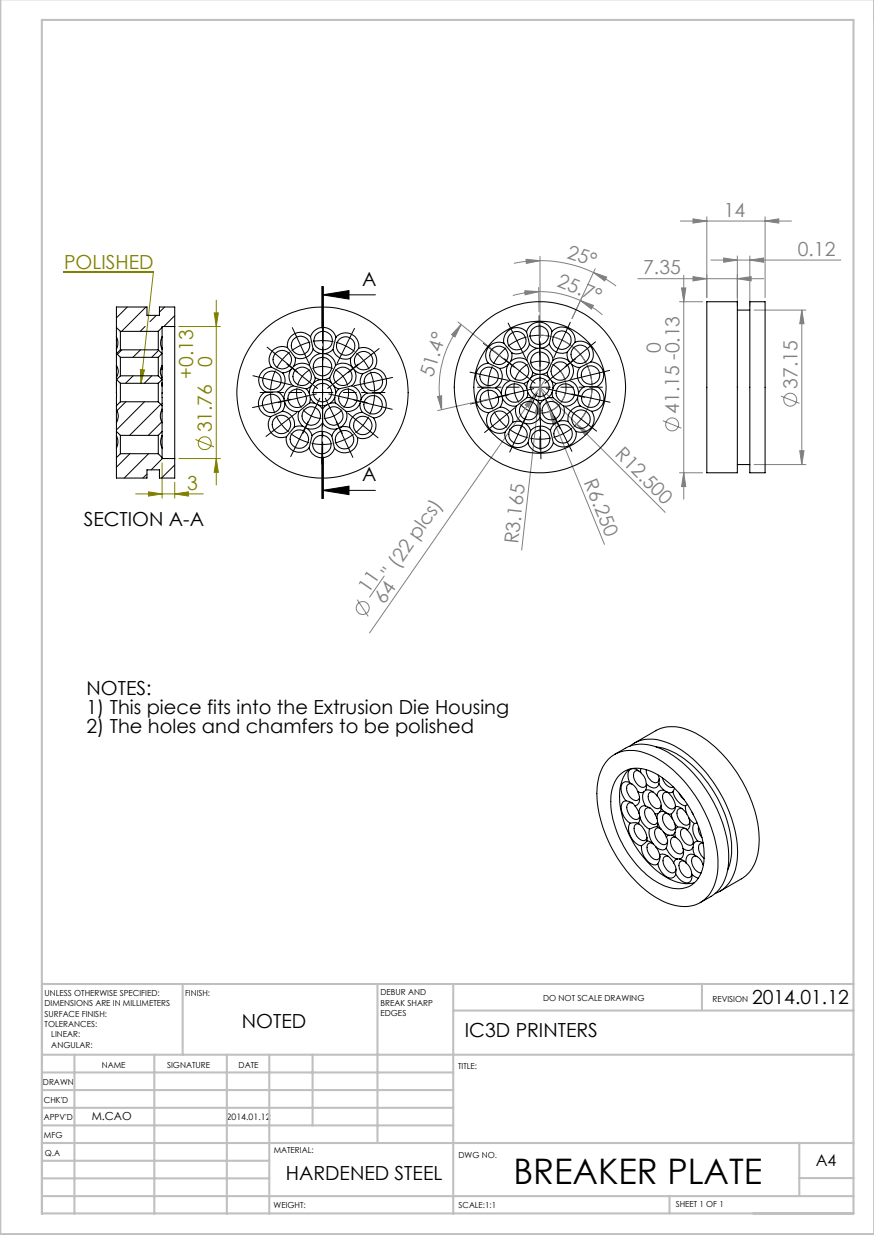
[picture p83: page 1]
64 " (22 plcs); SECTION A-A; IC3D PRINTERS; SCALE:1:1; SHEET 1 OF 1; DO NOT SCALE DRAWING; REVISION; DEBUR AND BREAK SHARP; UNLESS OTHERWISE SPECIFIED:; FINISH:

NOTES:
1) This piece fits into the Extrusion Die Housing
2) The holes and chamfers to be polished

DIMENSIONS ARE IN MILLIMETERS
SURFACE FINISH:
TOLERANCES:
LINEAR:
ANGULAR:

NAME | SIGNATURE | DATE | | | | TITLE:

DRAWN
CHK'D
APPV'D | M.CAO | | 2014.01.12
MFG
Q.A | | | | MATERIAL: HARDENED STEEL | DWG NO. BREAKER PLATE WEIGHT: | A4
