IC3DPrinters/filament-extrusion/Open Source Filament/CAD/Extrusion Dies/Extrusion Die 1.75mm 2013.12.23.PDF

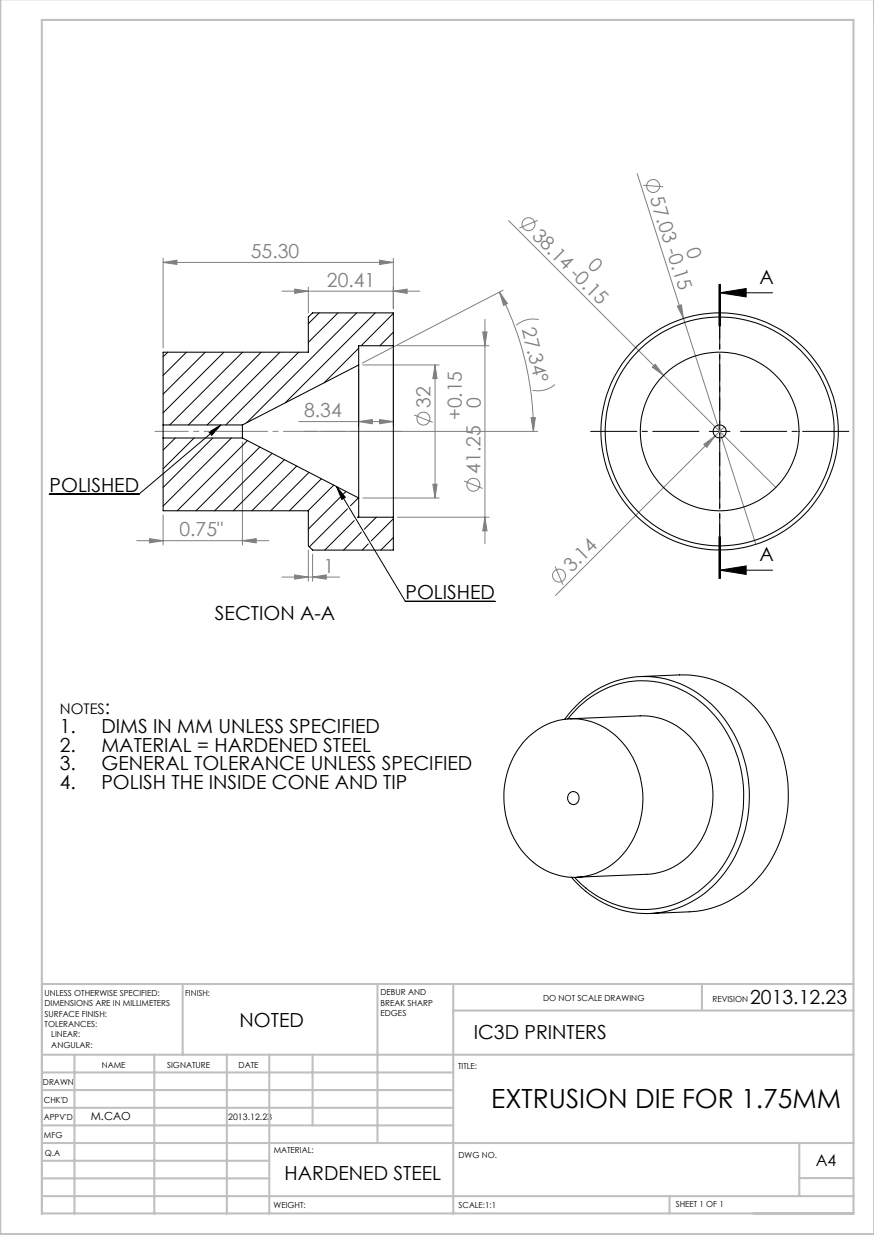
[picture p84: page 1]
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

NOTES:
1. DIMS IN MM UNLESS SPECIFIED
2. MATERIAL = HARDENED STEEL
3. GENERAL TOLERANCE UNLESS SPECIFIED
4. POLISH THE INSIDE CONE AND TIP

DIMENSIONS ARE IN MILLIMETERS
SURFACE FINISH:
TOLERANCES:
LINEAR:
ANGULAR:

NAME | SIGNATURE | DATE | | | | TITLE: EXTRUSION DIE FOR 1.75MM

DRAWN
CHK'D
APPV'D | M.CAO | | 2013.12.23
Q.A | | | | MATERIAL: HARDENED STEEL | DWG NO. | A4

MFG
