IC3DPrinters/filament-extrusion/(commit log)

2017-04-15 Uploading of the Full IC3D Open source FIlament source files and docs
    [3_16 Groove Bearing.SLDPRT, 3mm Filament.SLDPRT, 5_16 Nut.SLDPRT, 6153K150.SLDPRT, Adapter Traverse Pulley.SLDPRT, Bearing Plate Sym.STL, Bearing Plate Sym.sldprt, Bearing Plate.STL]
2017-05-08 IC3D Printers Logo and ABSNatural Filament Images
